codeThatThinks/io-master-dev-board/Readme.md

# io-master-dev-board

A dev board for continuing development of the I/O Master.
