codeThatThinks/io-master-dev-board/pdf/Schematic.pdf

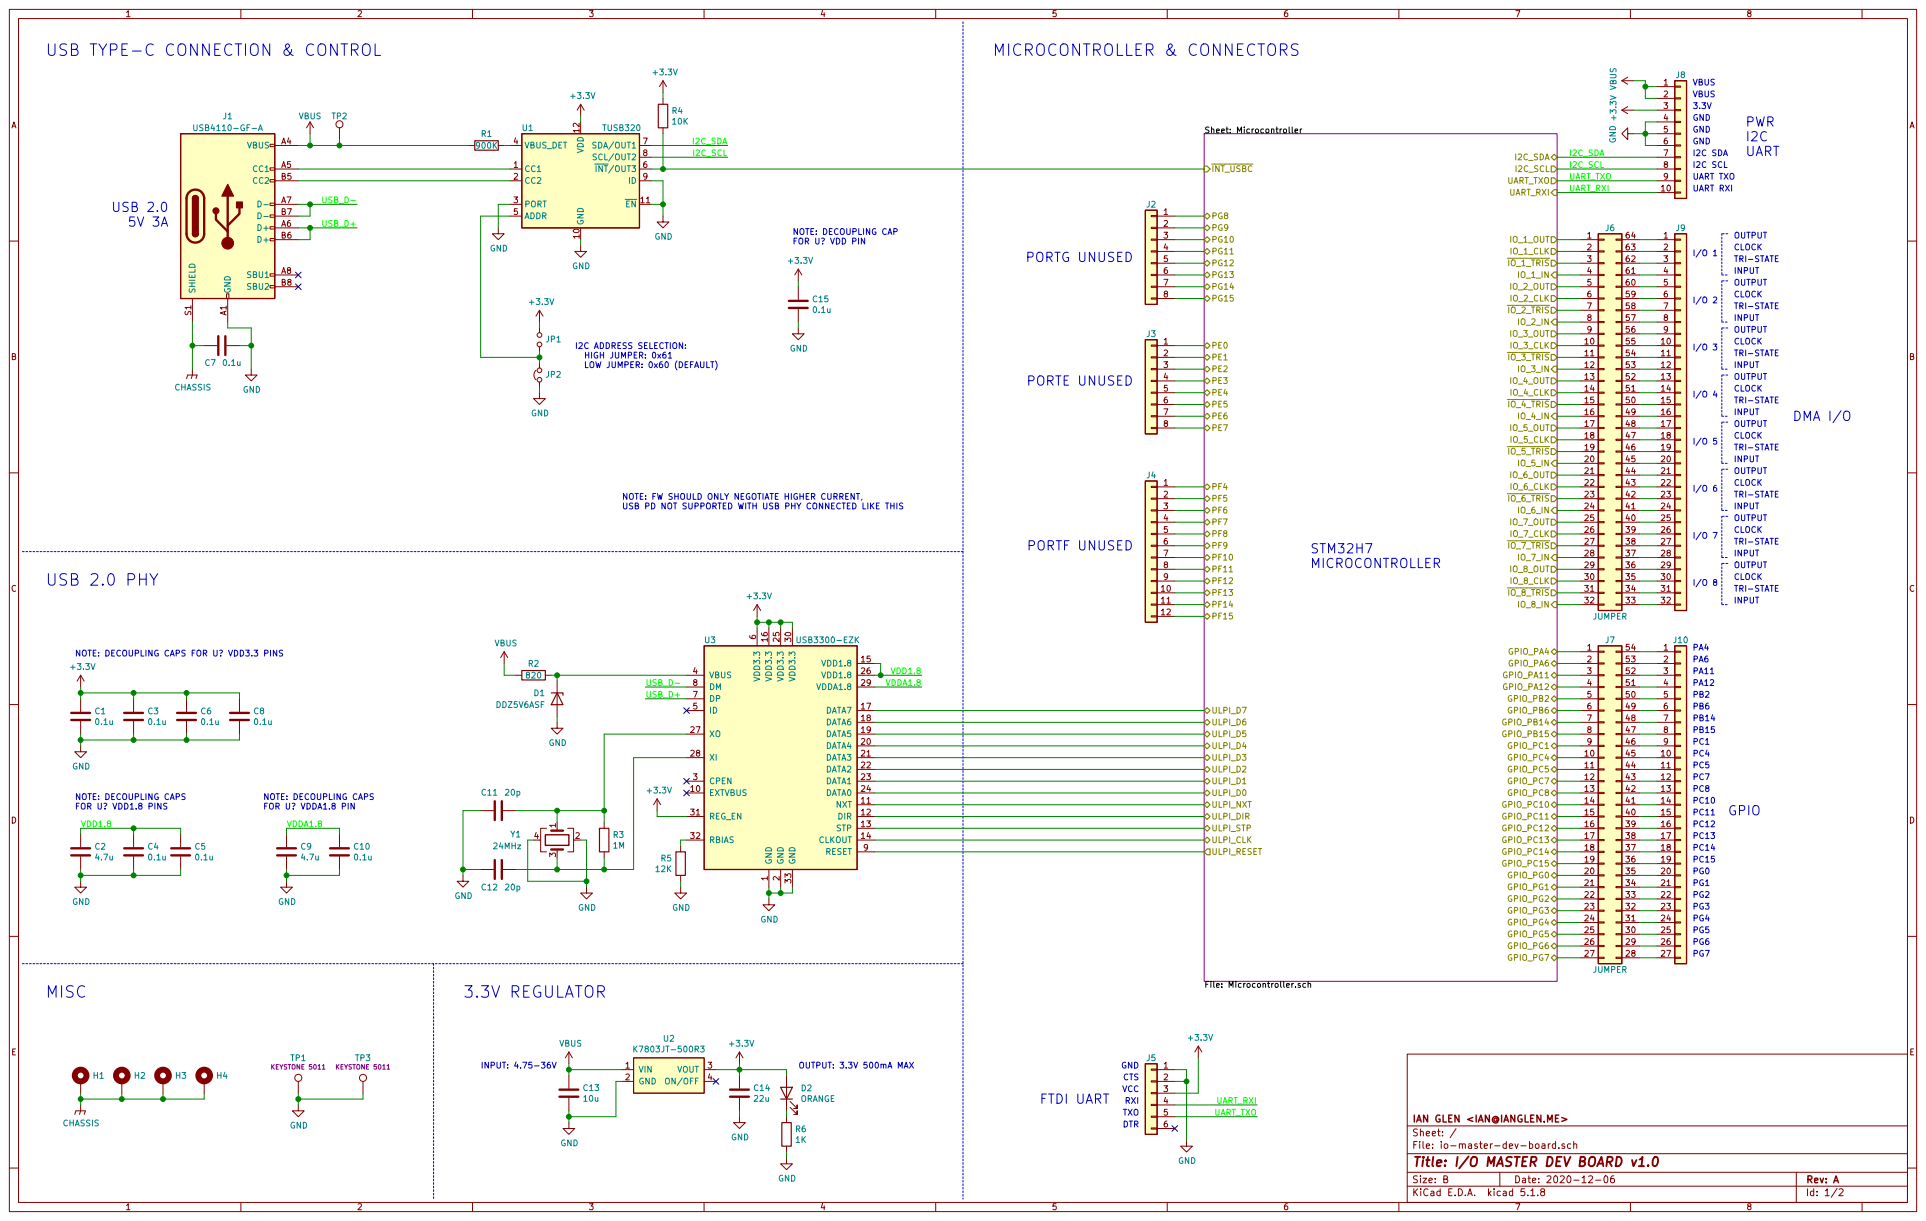
[picture p1: page 1]

FOR U? VDDA1.8 PIN USB TYPE-C CONNECTION & CONTROL

TRI-STATE CLOCK OUTPUT

4 | 2 | 63 2
5 | 3 | 62 3
6 | 4 | 61 4
7 | 5 | 60 5
8 | 6 | 59 6

7 | 58 7
8 | 57 8
9 | 56 9
10 | 55 10

2 | 11 | 54 11
3 | 12 | 53 12
4 | 13 | 52 13
5 | 14 | 51 14
6 | 15 | 50 15
7 | 16 | 49 16
8 | 17 | 48 17

18 | 47 18
19 | 46 19
20 | 45 20
21 | 44 21
22 | 43 22

2 | 23 | 42 23
3 | 24 | 41 24
4 | 25 | 40 25
5 | 26 | 39 26
6 | 27 | 38 27

9 | 30 | 35 30
10 | 31 | 34 31
11 | 32 | 33 32

6 DP 7 DM 8 RESET 9 U3 USB3300-EZK C1

1 EXTVBUS 10 NXT 11 DIR 12 STP 13 CLKOUT 14 VDD1.8 15 VDD3.3 16 DATA7 17 DATA6 18 DATA5 19 GND

2 DATA4 20 DATA3 21 DATA2 22 DATA1 23 DATA0 24 VDD3.3 25 VDD1.8 26 XO 27 XI 28 VDDA1.8 29 CPEN 3 VDD3.3 30 REG_EN 31 RBIAS 32 GND 33 VBUS 4

2 | 53 2
3 | 52 3
4 | 51 4
5 | 50 5
6 | 49 6
7 | 48 7
8 | 47 8
9 | 46 9
10 | 45 10
11 | 44 11
12 | 43 12
13 | 42 13
14 | 41 14
15 | 40 15
16 | 39 16
17 | 38 17
18 | 37 18
19 | 36 19
20 | 35 20

CTS NOTE: DECOUPLING CAPS

22 | 33 22
23 | 32 23
24 | 31 24
25 | 30 25
26 | 29 26
27 | 28 27

IAN GLEN <IAN@IANGLEN.ME>
File: io-master-dev-board.sch Sheet: /
Id: 1/2 Title: I/O MASTER DEV BOARD v1.0

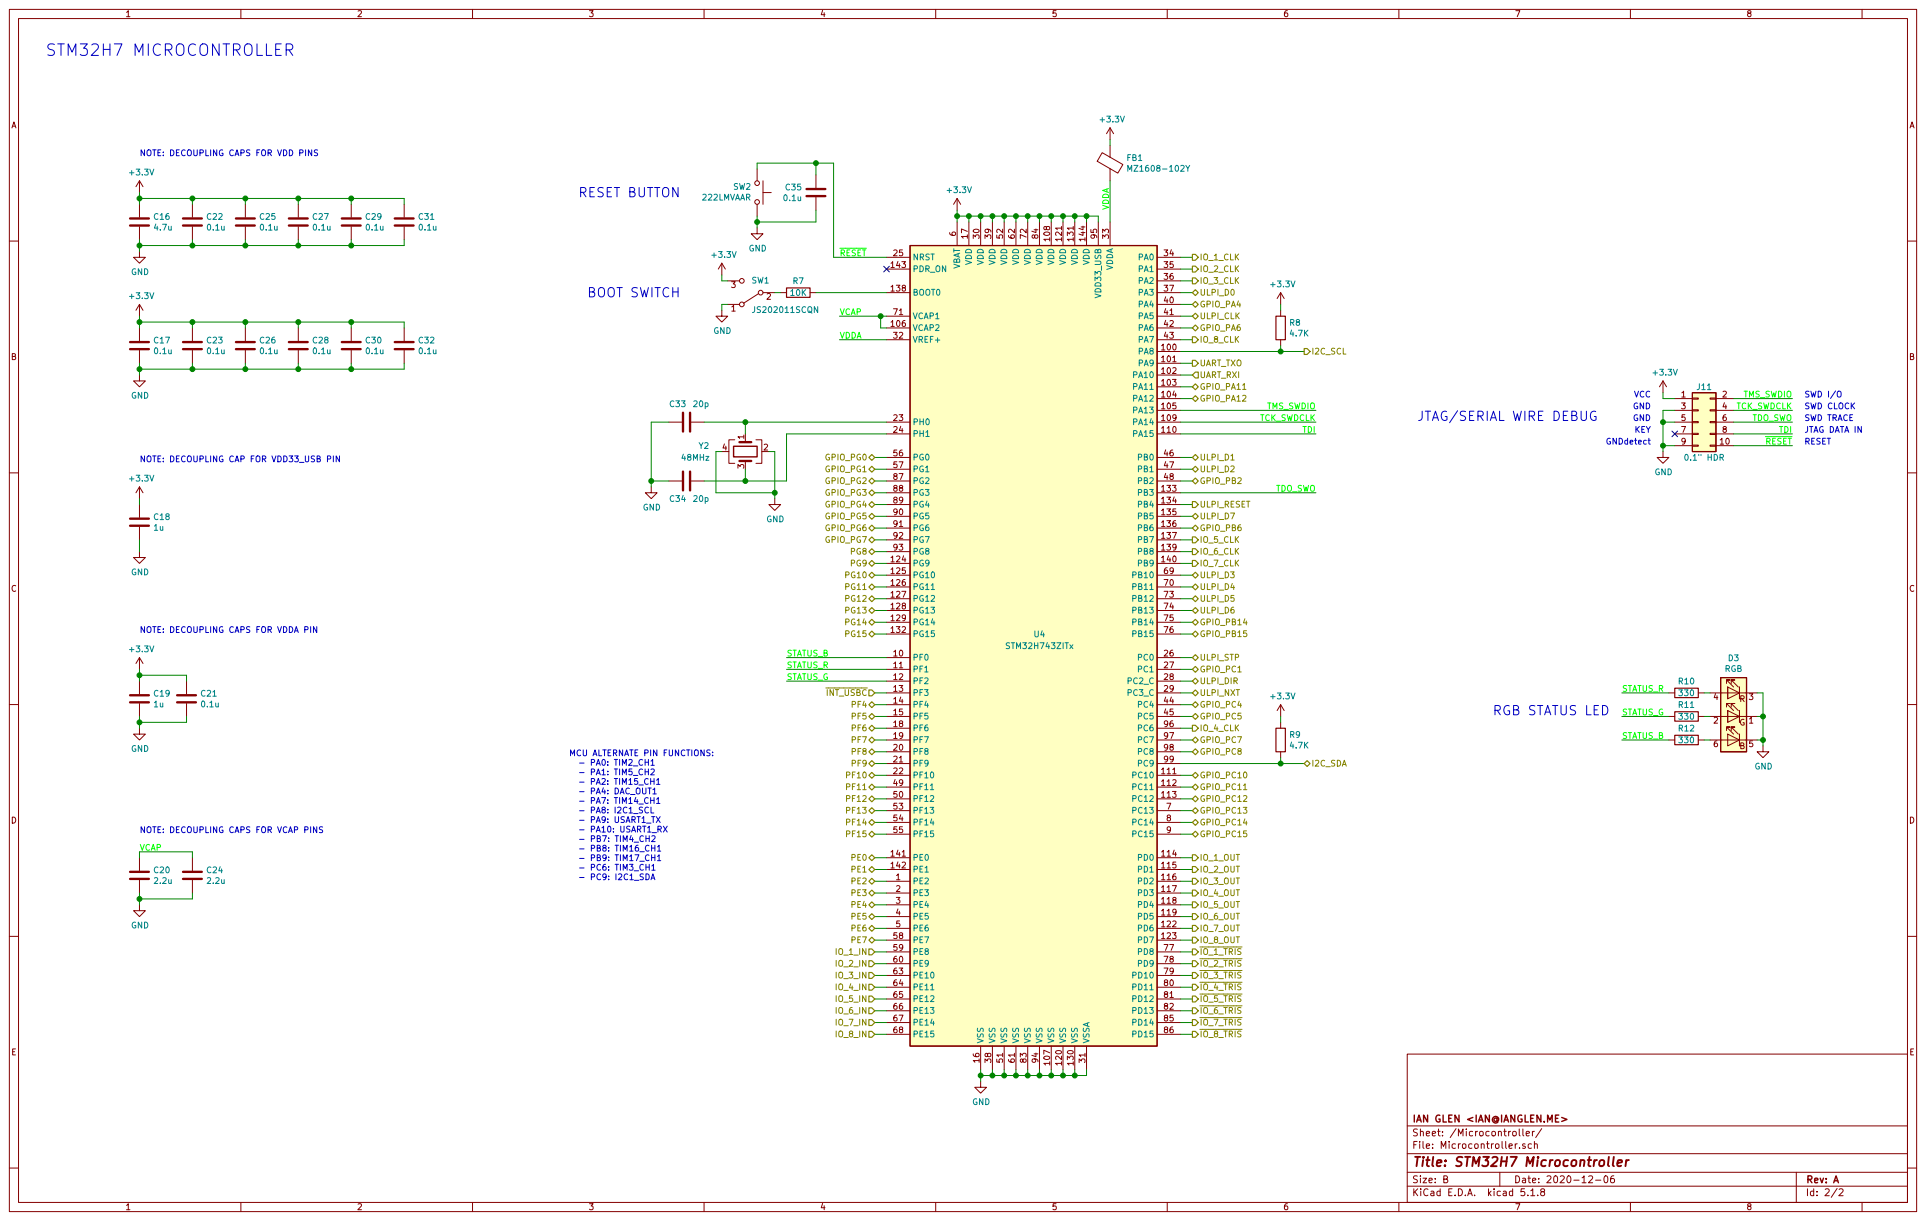
[picture p2: page 2]

JTAG/SERIAL WIRE DEBUG

NOTE: DECOUPLING CAP FOR VDD33_USB PIN

IAN GLEN <IAN@IANGLEN.ME> GND

Id: 2/2 Title: STM32H7 Microcontroller File: Microcontroller.sch Sheet: /Microcontroller/
