codeThatThinks/io-master-dev-board/kicad/io-master-dev-board.kicad_pcb

## KiCad design kicad/io-master-dev-board.kicad_pcb (2021-12-11)

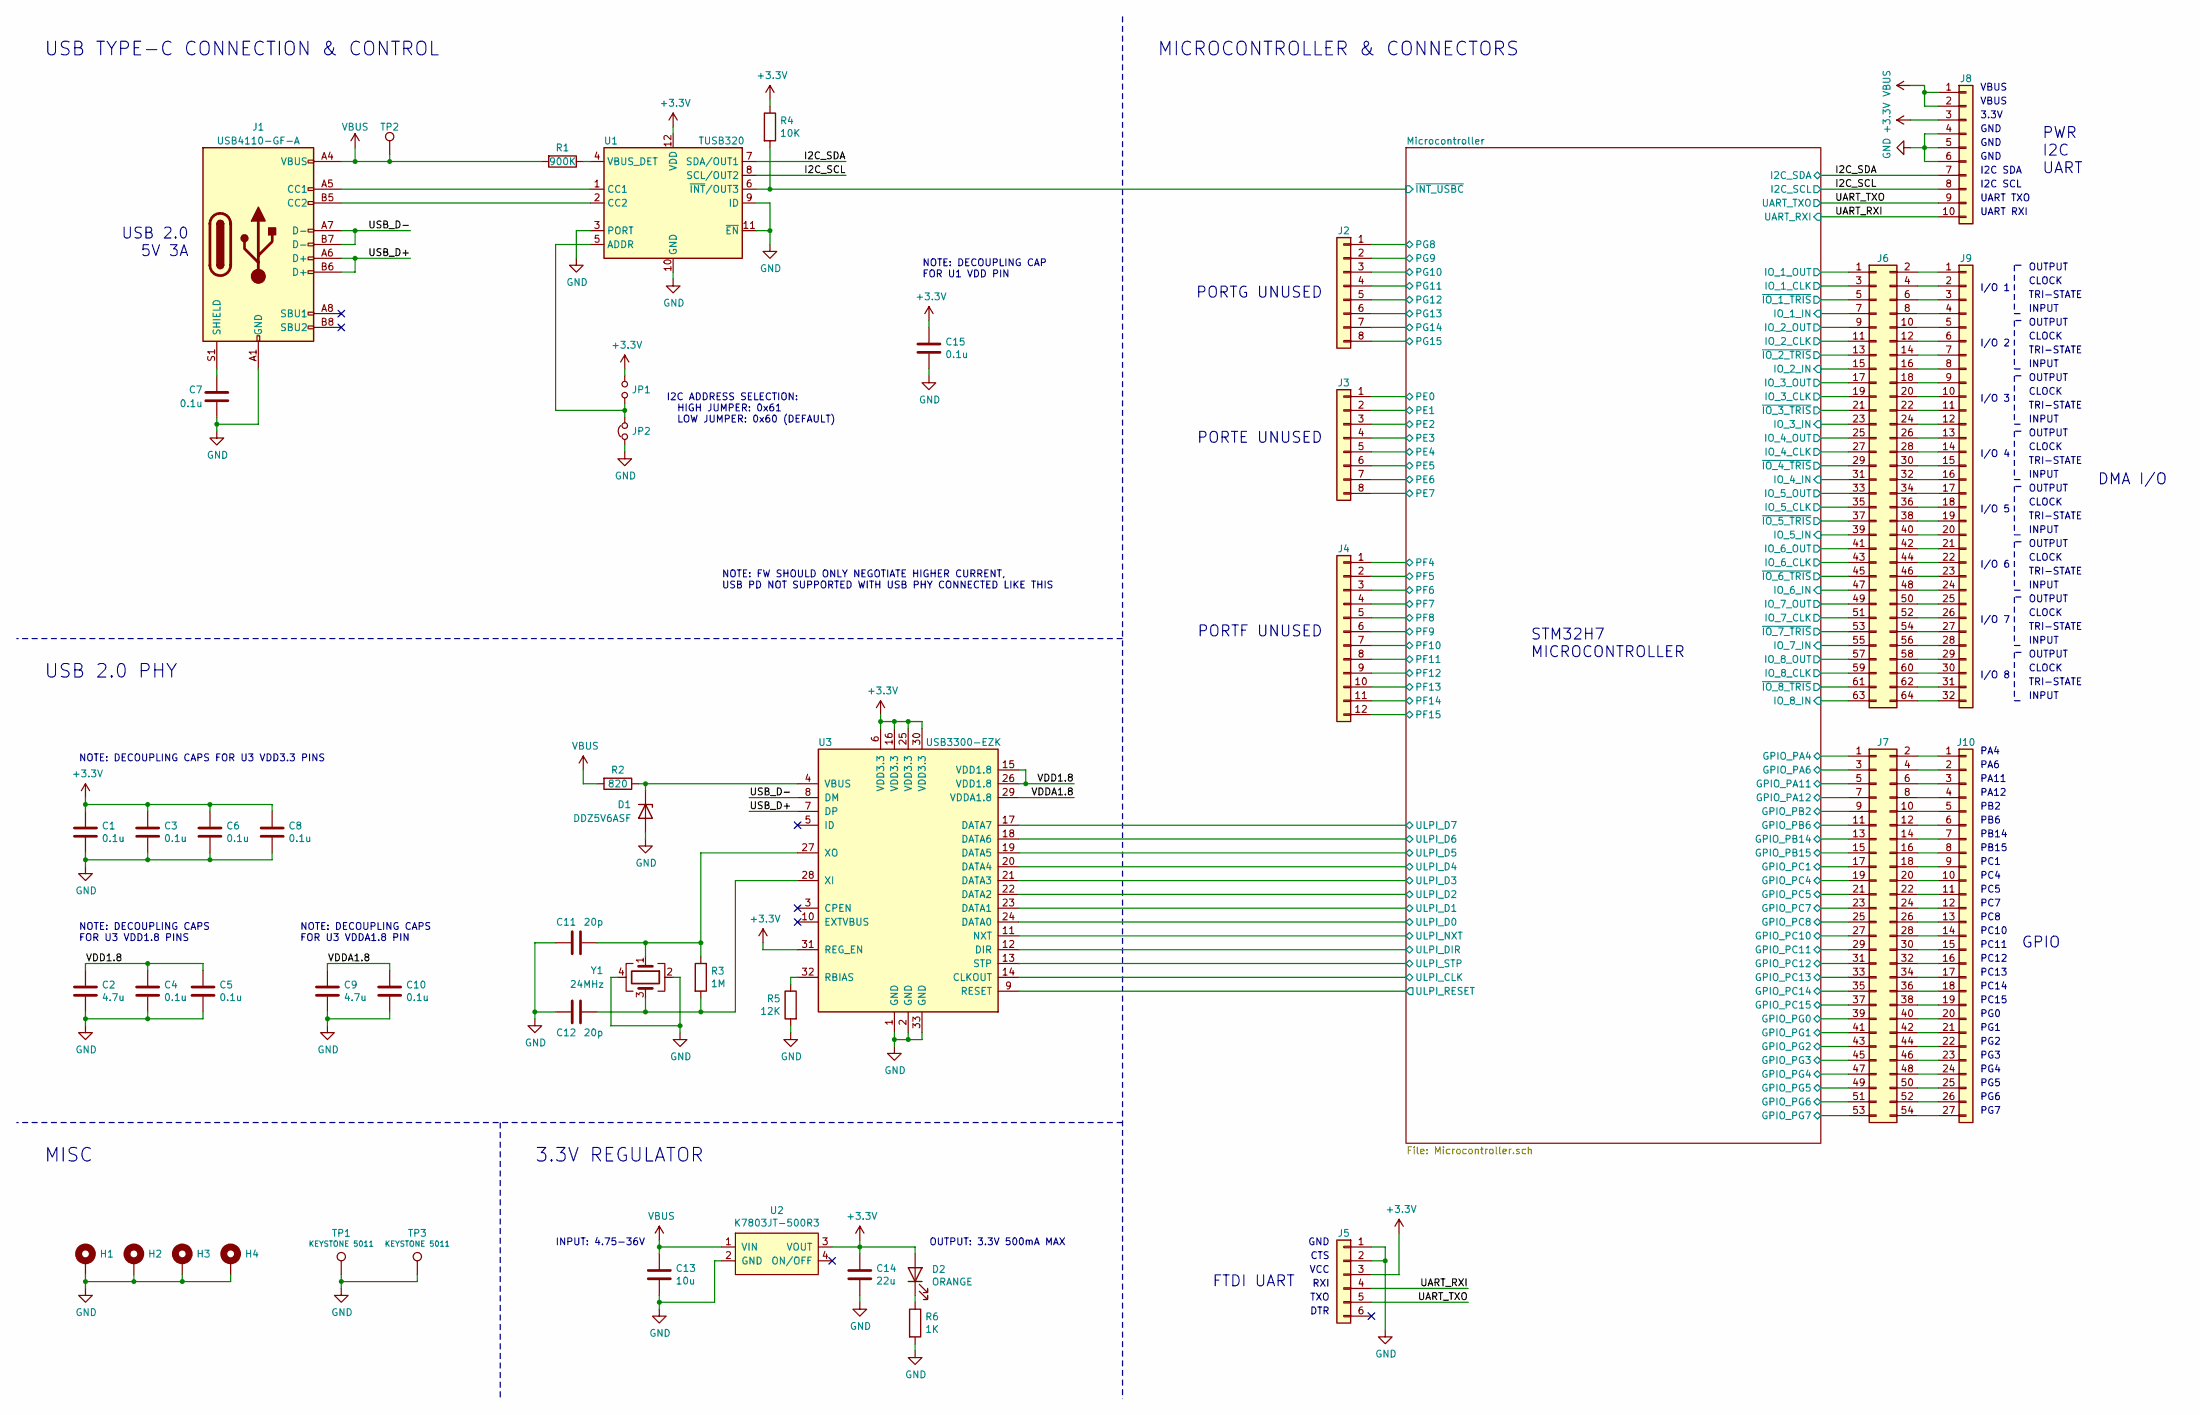
[picture p3: schematic io-master-dev-board.sch, I/O MASTER DEV BOARD v1.0]

Parts:
C1, C3, C4, C5, C6, C7, C8, C10, C15: 0.1u; C_0603_1608Metric
C2, C9: 4.7u; C_0805_2012Metric
C11, C12: 20p; C_0603_1608Metric
C13: 10u; C_0805_2012Metric
C14: 22u; C_1210_3225Metric
D1: DDZ5V6ASF; D_SOD-323F
D2: ORANGE; LED_0603_1608Metric
H1, H2, H3, H4: M3; MountingHole_3.2mm_M3_Pad
J1: USB4110-GF-A; USB_C_Receptable_GCT_USB4110
J2, J3: Conn_01x08; PinHeader_1x08_P2.54mm_Vertical
J4: Conn_01x12; PinHeader_1x12_P2.54mm_Vertical
J5: UART; PinHeader_1x06_P2.54mm_Horizontal
J6: Conn_02x32_Odd_Even; PinHeader_2x32_P1.27mm_Vertical
J7: Conn_02x27_Odd_Even; PinHeader_2x27_P1.27mm_Vertical
J8: Conn_01x10; PinHeader_1x10_P1.27mm_Vertical
J9: Conn_01x32; PinHeader_1x32_P1.27mm_Vertical
J10: Conn_01x27; PinHeader_1x27_P1.27mm_Vertical
JP1: Jumper_NO_Small; R_0603_1608Metric
JP2: Jumper_NC_Small; R_0603_1608Metric
R1: 900K; R_0603_1608Metric
R2: 820; R_0603_1608Metric
R3: 1M; R_0603_1608Metric
R4: 10K; R_0603_1608Metric
R5: 12K; R_0603_1608Metric
R6: 1K; R_0603_1608Metric
TP1, TP3: GND; TestPoint_Keystone_5010-5014_Multipurpose
TP2: VBUS; TestPoint_Pad_D1.0mm
U1: TUSB320; Texas_X2QFN-12_1.6x1.6mm_P0.4mm
U2: K7803JT-500R3; DCDC_Module_K78xxJT-500R3
U3: USB3300-EZK; QFN-32-1EP_5x5mm_P0.5mm_EP3.45x3.45mm
Y1: 24MHz; Crystal_SMD_Murata_XRCGB

Connections:
+3V3: C1.1, C3.1, C6.1, C8.1, C14.1, C15.1, D2.2 (A), J5.3, J8.3, JP1.2, R4.1, U1.12 (VDD), U2.3 (VOUT), U3.6 (VDD3.3), U3.16 (VDD3.3), U3.25 (VDD3.3), U3.30 (VDD3.3), U3.31 (REG_EN); also elsewhere on the board
/I2C_SCL: J8.8, U1.8 (SCL/OUT2); also elsewhere on the board
/I2C_SDA: J8.7, U1.7 (SDA/OUT1); also elsewhere on the board
/Microcontroller/GPIO_PA4: J7.1; also elsewhere on the board
/Microcontroller/GPIO_PA6: J7.3; also elsewhere on the board
/Microcontroller/GPIO_PA11: J7.5; also elsewhere on the board
/Microcontroller/GPIO_PA12: J7.7; also elsewhere on the board
/Microcontroller/GPIO_PB2: J7.9; also elsewhere on the board
/Microcontroller/GPIO_PB6: J7.11; also elsewhere on the board
/Microcontroller/GPIO_PB14: J7.13; also elsewhere on the board
/Microcontroller/GPIO_PB15: J7.15; also elsewhere on the board
/Microcontroller/GPIO_PC1: J7.17; also elsewhere on the board
/Microcontroller/GPIO_PC4: J7.19; also elsewhere on the board
/Microcontroller/GPIO_PC5: J7.21; also elsewhere on the board
/Microcontroller/GPIO_PC7: J7.23; also elsewhere on the board
/Microcontroller/GPIO_PC8: J7.25; also elsewhere on the board
/Microcontroller/GPIO_PC10: J7.27; also elsewhere on the board
/Microcontroller/GPIO_PC11: J7.29; also elsewhere on the board
/Microcontroller/GPIO_PC12: J7.31; also elsewhere on the board
/Microcontroller/GPIO_PC13: J7.33; also elsewhere on the board
/Microcontroller/GPIO_PC14: J7.35; also elsewhere on the board
/Microcontroller/GPIO_PC15: J7.37; also elsewhere on the board
/Microcontroller/GPIO_PG0: J7.39; also elsewhere on the board
/Microcontroller/GPIO_PG1: J7.41; also elsewhere on the board
/Microcontroller/GPIO_PG2: J7.43; also elsewhere on the board
/Microcontroller/GPIO_PG3: J7.45; also elsewhere on the board
/Microcontroller/GPIO_PG4: J7.47; also elsewhere on the board
/Microcontroller/GPIO_PG5: J7.49; also elsewhere on the board
/Microcontroller/GPIO_PG6: J7.51; also elsewhere on the board
/Microcontroller/GPIO_PG7: J7.53; also elsewhere on the board
/Microcontroller/IO_1_CLK: J6.3; also elsewhere on the board
/Microcontroller/IO_1_IN: J6.7; also elsewhere on the board
/Microcontroller/IO_1_OUT: J6.1; also elsewhere on the board
/Microcontroller/IO_2_CLK: J6.11; also elsewhere on the board
/Microcontroller/IO_2_IN: J6.15; also elsewhere on the board
/Microcontroller/IO_2_OUT: J6.9; also elsewhere on the board
/Microcontroller/IO_3_CLK: J6.19; also elsewhere on the board
/Microcontroller/IO_3_IN: J6.23; also elsewhere on the board
/Microcontroller/IO_3_OUT: J6.17; also elsewhere on the board
/Microcontroller/IO_4_CLK: J6.27; also elsewhere on the board
/Microcontroller/IO_4_IN: J6.31; also elsewhere on the board
/Microcontroller/IO_4_OUT: J6.25; also elsewhere on the board
/Microcontroller/IO_5_CLK: J6.35; also elsewhere on the board
/Microcontroller/IO_5_IN: J6.39; also elsewhere on the board
/Microcontroller/IO_5_OUT: J6.33; also elsewhere on the board
/Microcontroller/IO_6_CLK: J6.43; also elsewhere on the board
/Microcontroller/IO_6_IN: J6.47; also elsewhere on the board
/Microcontroller/IO_6_OUT: J6.41; also elsewhere on the board
/Microcontroller/IO_7_CLK: J6.51; also elsewhere on the board
/Microcontroller/IO_7_IN: J6.55; also elsewhere on the board
/Microcontroller/IO_7_OUT: J6.49; also elsewhere on the board
/Microcontroller/IO_8_CLK: J6.59; also elsewhere on the board
/Microcontroller/IO_8_IN: J6.63; also elsewhere on the board
/Microcontroller/IO_8_OUT: J6.57; also elsewhere on the board
/Microcontroller/PE0: J3.1; also elsewhere on the board
/Microcontroller/PE1: J3.2; also elsewhere on the board
/Microcontroller/PE2: J3.3; also elsewhere on the board
/Microcontroller/PE3: J3.4; also elsewhere on the board
/Microcontroller/PE4: J3.5; also elsewhere on the board
/Microcontroller/PE5: J3.6; also elsewhere on the board
/Microcontroller/PE6: J3.7; also elsewhere on the board
/Microcontroller/PE7: J3.8; also elsewhere on the board
/Microcontroller/PF4: J4.1; also elsewhere on the board
/Microcontroller/PF5: J4.2; also elsewhere on the board
/Microcontroller/PF6: J4.3; also elsewhere on the board
/Microcontroller/PF7: J4.4; also elsewhere on the board
/Microcontroller/PF8: J4.5; also elsewhere on the board
/Microcontroller/PF9: J4.6; also elsewhere on the board
/Microcontroller/PF10: J4.7; also elsewhere on the board
/Microcontroller/PF11: J4.8; also elsewhere on the board
/Microcontroller/PF12: J4.9; also elsewhere on the board
/Microcontroller/PF13: J4.10; also elsewhere on the board
/Microcontroller/PF14: J4.11; also elsewhere on the board
/Microcontroller/PF15: J4.12; also elsewhere on the board
/Microcontroller/PG8: J2.1; also elsewhere on the board
/Microcontroller/PG9: J2.2; also elsewhere on the board
/Microcontroller/PG10: J2.3; also elsewhere on the board
/Microcontroller/PG11: J2.4; also elsewhere on the board
/Microcontroller/PG12: J2.5; also elsewhere on the board
/Microcontroller/PG13: J2.6; also elsewhere on the board
/Microcontroller/PG14: J2.7; also elsewhere on the board
/Microcontroller/PG15: J2.8; also elsewhere on the board
/Microcontroller/ULPI_CLK: U3.14 (CLKOUT); also elsewhere on the board
/Microcontroller/ULPI_D0: U3.24 (DATA0); also elsewhere on the board
/Microcontroller/ULPI_D1: U3.23 (DATA1); also elsewhere on the board
/Microcontroller/ULPI_D2: U3.22 (DATA2); also elsewhere on the board
/Microcontroller/ULPI_D3: U3.21 (DATA3); also elsewhere on the board
/Microcontroller/ULPI_D4: U3.20 (DATA4); also elsewhere on the board
/Microcontroller/ULPI_D5: U3.19 (DATA5); also elsewhere on the board
/Microcontroller/ULPI_D6: U3.18 (DATA6); also elsewhere on the board
/Microcontroller/ULPI_D7: U3.17 (DATA7); also elsewhere on the board
/Microcontroller/ULPI_DIR: U3.12 (DIR); also elsewhere on the board
/Microcontroller/ULPI_NXT: U3.11 (NXT); also elsewhere on the board
/Microcontroller/ULPI_RESET: U3.9 (RESET); also elsewhere on the board
/Microcontroller/ULPI_STP: U3.13 (STP); also elsewhere on the board
/Microcontroller/~INT_USBC: R4.2, U1.6 (~INT~/OUT3); also elsewhere on the board
/Microcontroller/~IO_1_TRIS: J6.5; also elsewhere on the board
/Microcontroller/~IO_2_TRIS: J6.13; also elsewhere on the board
/Microcontroller/~IO_3_TRIS: J6.21; also elsewhere on the board
/Microcontroller/~IO_4_TRIS: J6.29; also elsewhere on the board
/Microcontroller/~IO_5_TRIS: J6.37; also elsewhere on the board
/Microcontroller/~IO_6_TRIS: J6.45; also elsewhere on the board
/Microcontroller/~IO_7_TRIS: J6.53; also elsewhere on the board
/Microcontroller/~IO_8_TRIS: J6.61; also elsewhere on the board
/UART_RXI: J5.4, J8.10; also elsewhere on the board
/UART_TXO: J5.5, J8.9; also elsewhere on the board
/USB_D+: J1.A6 (D+), J1.B6 (D+), U3.7 (DP)
/USB_D-: J1.A7 (D-), J1.B7 (D-), U3.8 (DM)
/VDD1.8: C2.1, C4.1, C5.1, U3.15 (VDD1.8), U3.26 (VDD1.8)
/VDDA1.8: C9.1, C10.1, U3.29 (VDDA1.8)
GND: C1.2, C2.2, C3.2, C4.2, C5.2, C6.2, C7.1, C8.2, C9.2, C10.2, C11.2, C12.2, C13.2, C14.2, C15.2, D1.2 (A), H1.1, H2.1, H3.1, H4.1, J1.A1 (GND), J1.A12 (GND), J1.B1 (GND), J1.B12 (GND), J5.1, J5.2, J8.4, J8.5, J8.6, JP2.1, R5.2, R6.2, TP1.1, TP3.1, U1.3 (PORT), U1.9 (ID), U1.10 (GND), U1.11 (~EN), U2.2 (GND), U3.1 (GND), U3.2 (GND), U3.33 (GND), Y1.2, Y1.4; also elsewhere on the board
unnamed: C7.2, J1.S1 (SHIELD)
unnamed: C11.1, R3.1, U3.27 (XO), Y1.1
unnamed: C12.1, R3.2, U3.28 (XI), Y1.3
unnamed: D1.1 (K), R2.1, U3.4 (VBUS)
unnamed: D2.1 (K), R6.1
unnamed: J1.A5 (CC1), U1.1 (CC1)
unnamed: J1.B5 (CC2), U1.2 (CC2)
unnamed: J6.2, J9.1
unnamed: J6.4, J9.2
unnamed: J6.6, J9.3
unnamed: J6.8, J9.4
unnamed: J6.10, J9.5
unnamed: J6.12, J9.6
unnamed: J6.14, J9.7
unnamed: J6.16, J9.8
unnamed: J6.18, J9.9
unnamed: J6.20, J9.10
unnamed: J6.22, J9.11
unnamed: J6.24, J9.12
unnamed: J6.26, J9.13
unnamed: J6.28, J9.14
unnamed: J6.30, J9.15
unnamed: J6.32, J9.16
unnamed: J6.34, J9.17
unnamed: J6.36, J9.18
unnamed: J6.38, J9.19
unnamed: J6.40, J9.20
unnamed: J6.42, J9.21
unnamed: J6.44, J9.22
unnamed: J6.46, J9.23
unnamed: J6.48, J9.24
unnamed: J6.50, J9.25
unnamed: J6.52, J9.26
unnamed: J6.54, J9.27
unnamed: J6.56, J9.28
unnamed: J6.58, J9.29
unnamed: J6.60, J9.30
unnamed: J6.62, J9.31
unnamed: J6.64, J9.32
unnamed: J7.2, J10.1
unnamed: J7.4, J10.2
unnamed: J7.6, J10.3
unnamed: J7.8, J10.4
unnamed: J7.10, J10.5
unnamed: J7.12, J10.6
unnamed: J7.14, J10.7
unnamed: J7.16, J10.8
unnamed: J7.18, J10.9
unnamed: J7.20, J10.10
unnamed: J7.22, J10.11
unnamed: J7.24, J10.12
unnamed: J7.26, J10.13
unnamed: J7.28, J10.14
unnamed: J7.30, J10.15
unnamed: J7.32, J10.16
unnamed: J7.34, J10.17
unnamed: J7.36, J10.18
unnamed: J7.38, J10.19
unnamed: J7.40, J10.20
unnamed: J7.42, J10.21
unnamed: J7.44, J10.22
unnamed: J7.46, J10.23
unnamed: J7.48, J10.24
unnamed: J7.50, J10.25
unnamed: J7.52, J10.26
unnamed: J7.54, J10.27
unnamed: JP1.1, JP2.2, U1.5 (ADDR)
unnamed: R1.1, U1.4 (VBUS_DET)
unnamed: R5.1, U3.32 (RBIAS)
VBUS: C13.1, J1.A4 (VBUS), J1.A9 (VBUS), J1.B4 (VBUS), J1.B9 (VBUS), J8.1, J8.2, R1.2, R2.2, TP2.1, U2.1 (VIN)

Notes on the sheet:
NOTE: DECOUPLING CAPS FOR U3 VDD1.8 PINS
NOTE: DECOUPLING CAPS FOR U3 VDD3.3 PINS
NOTE: DECOUPLING CAPS FOR U3 VDDA1.8 PIN
USB TYPE-C CONNECTION & CONTROL
USB 2.0 5V 3A
3.3V REGULATOR
I2C ADDRESS SELECTION: HIGH JUMPER: 0x61 LOW JUMPER: 0x60 (DEFAULT)
NOTE: DECOUPLING CAP FOR U1 VDD PIN
INPUT: 4.75-36V
OUTPUT: 3.3V 500mA MAX
STM32H7 MICROCONTROLLER
USB 2.0 PHY
MISC
MICROCONTROLLER & CONNECTORS
PWR I2C UART
DMA I/O
VBUS
3.3V
GND
I2C SDA
I2C SCL
UART TXO
UART RXI
I/O 1
OUTPUT
CLOCK
TRI-STATE
INPUT
I/O 2
I/O 3
I/O 4
I/O 5
I/O 6
I/O 7
I/O 8
GPIO
PA4
PA6
PA11
PA12
PB2
PB6
PB14
PB15
PC1
PC4
PC5
PC7
PC8
PC10
PC11
PC12
PC13
PC14
PC15
PG0
PG1
PG2
PG3
PG4
PG5
PG6
PG7
PORTG UNUSED
PORTE UNUSED
PORTF UNUSED
VCC
TXO
RXI
FTDI UART
CTS
DTR
NOTE: FW SHOULD ONLY NEGOTIATE HIGHER CURRENT, USB PD NOT SUPPORTED WITH USB PHY CONNECTED LIKE THIS

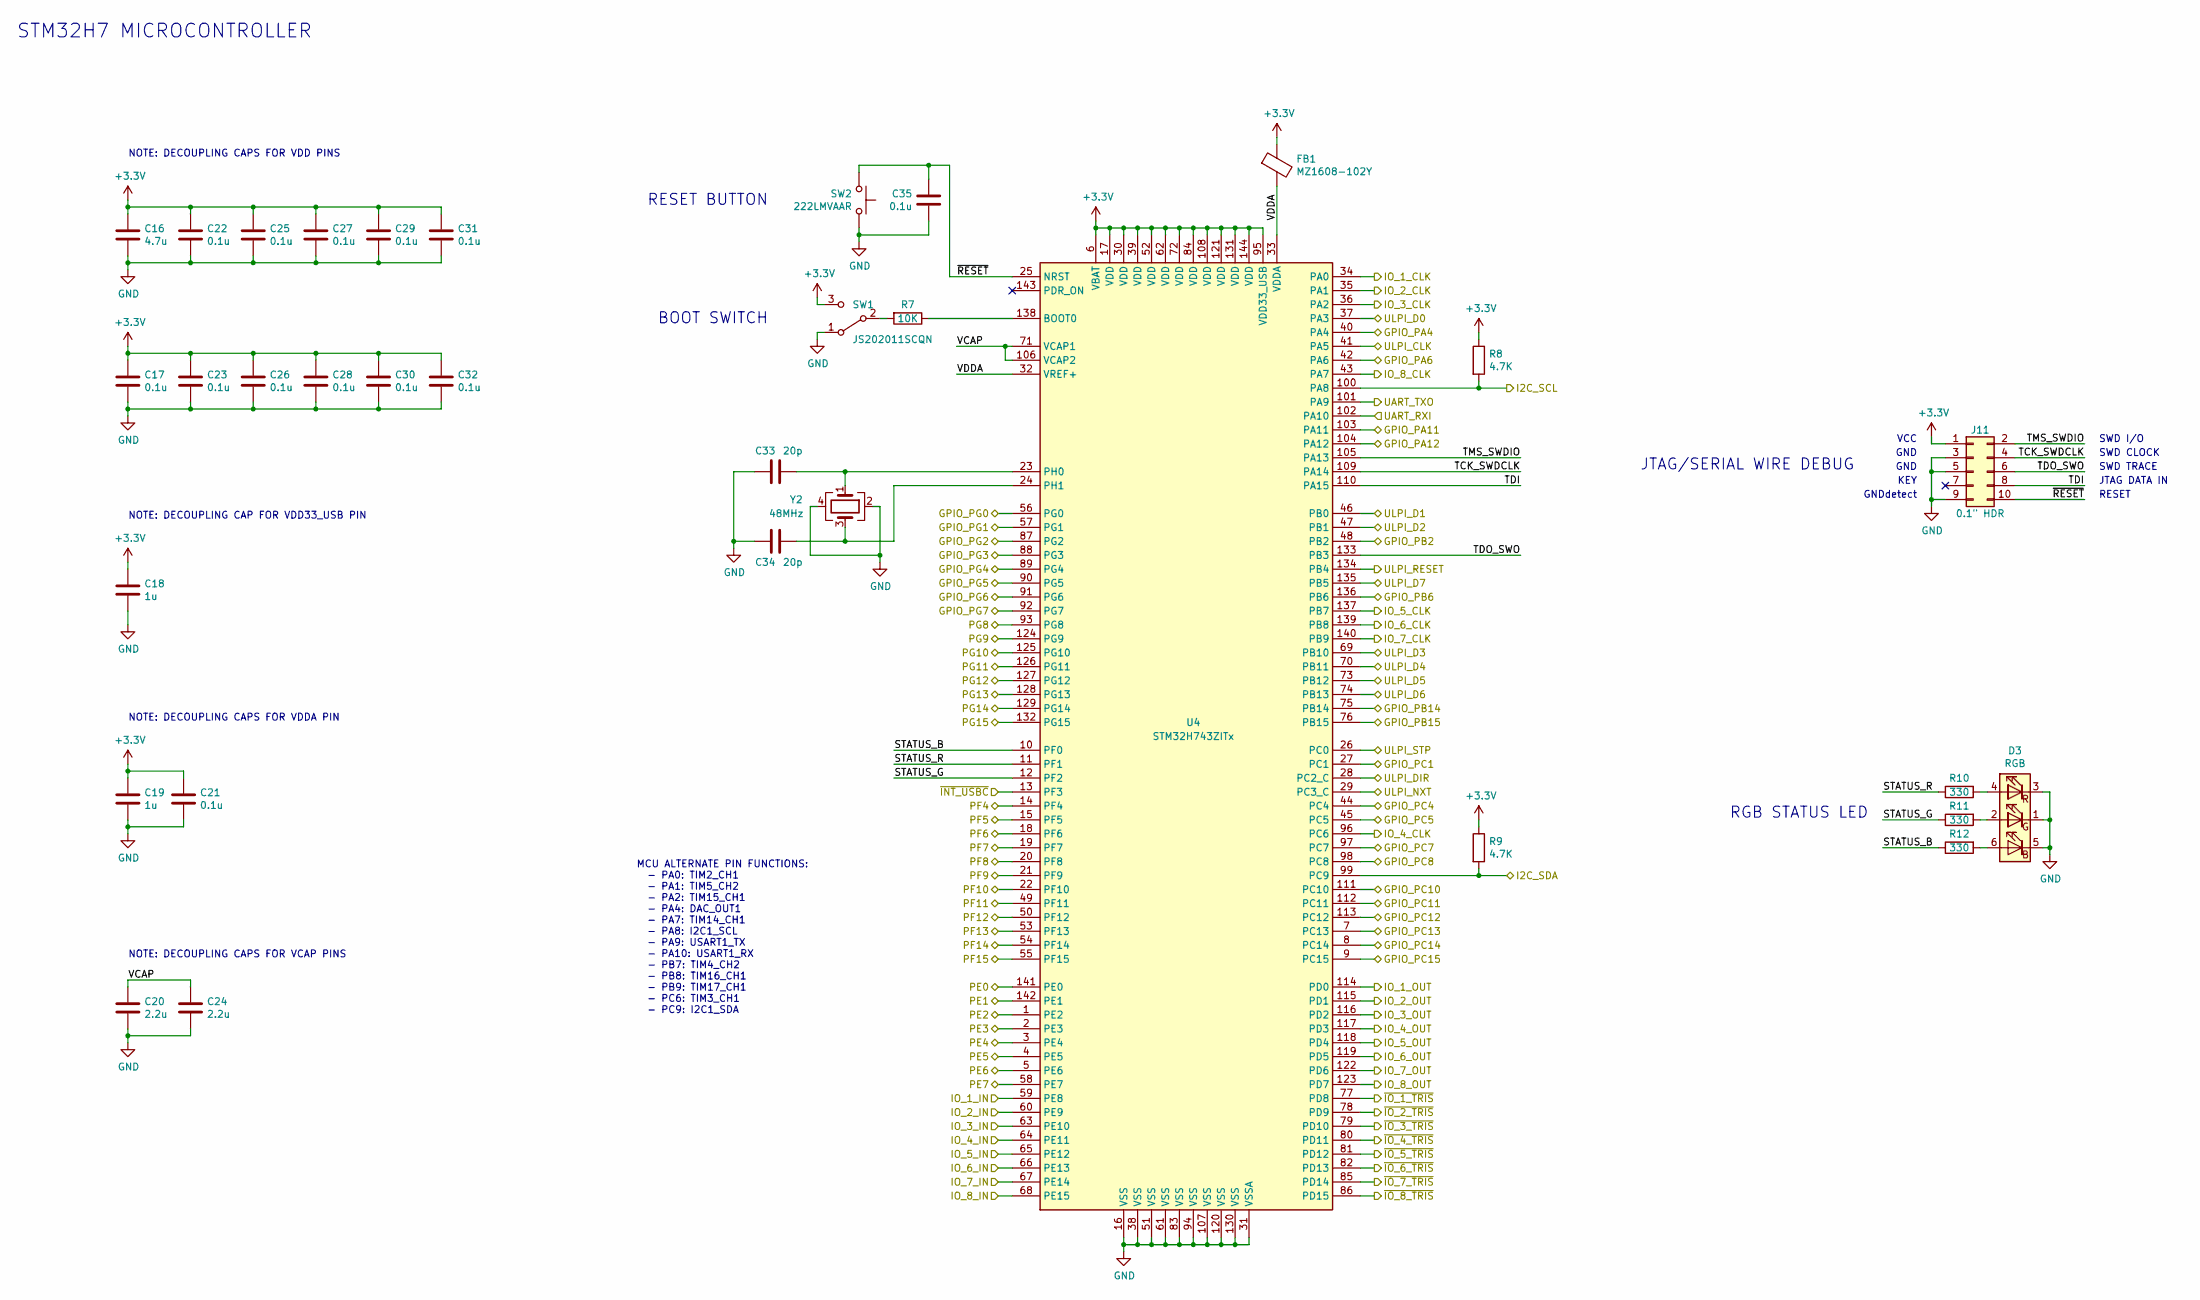
[picture p4: schematic Microcontroller.sch, STM32H7 Microcontroller]

Parts:
C16: 4.7u; C_0805_2012Metric
C17, C21, C22, C23, C25, C26, C27, C28, C29, C30, C31, C32, C35: 0.1u; C_0603_1608Metric
C18, C19: 1u; C_0603_1608Metric
C20, C24: 2.2u; C_0805_2012Metric
C33, C34: 20p; C_0603_1608Metric
D3: RGB; LED_Everlight_19-337C
FB1: MZ1608-102Y; R_0603_1608Metric
J11: 0.1\" HDR; PinSocket_2x05_P2.54mm_Vertical
R7: 10K; R_0603_1608Metric
R8, R9: 4.7K; R_0603_1608Metric
R10, R11, R12: 330; R_0603_1608Metric
SW1: JS202011SCQN; SW_DPDT_CK_JS202011SCQN
SW2: 222LMVAAR; SW_Push_CTS_222LMVA
U4: STM32H743ZITx; LQFP-144_20x20mm_P0.5mm
Y2: 48MHz; Crystal_SMD_Murata_XRCGB

Connections:
+3V3: C16.1, C17.1, C18.1, C19.1, C21.1, C22.1, C23.1, C25.1, C26.1, C27.1, C28.1, C29.1, C30.1, C31.1, C32.1, FB1.1, J11.1, R8.1, R9.1, SW1.3 (C), U4.6 (VBAT), U4.17 (VDD), U4.30 (VDD), U4.39 (VDD), U4.52 (VDD), U4.62 (VDD), U4.72 (VDD), U4.84 (VDD), U4.95 (VDD33_USB), U4.108 (VDD), U4.121 (VDD), U4.131 (VDD), U4.144 (VDD); also elsewhere on the board
/I2C_SCL: R8.2, U4.100 (PA8); also elsewhere on the board
/I2C_SDA: R9.2, U4.99 (PC9); also elsewhere on the board
/Microcontroller/GPIO_PA4: U4.40 (PA4); also elsewhere on the board
/Microcontroller/GPIO_PA6: U4.42 (PA6); also elsewhere on the board
/Microcontroller/GPIO_PA11: U4.103 (PA11); also elsewhere on the board
/Microcontroller/GPIO_PA12: U4.104 (PA12); also elsewhere on the board
/Microcontroller/GPIO_PB2: U4.48 (PB2); also elsewhere on the board
/Microcontroller/GPIO_PB6: U4.136 (PB6); also elsewhere on the board
/Microcontroller/GPIO_PB14: U4.75 (PB14); also elsewhere on the board
/Microcontroller/GPIO_PB15: U4.76 (PB15); also elsewhere on the board
/Microcontroller/GPIO_PC1: U4.27 (PC1); also elsewhere on the board
/Microcontroller/GPIO_PC4: U4.44 (PC4); also elsewhere on the board
/Microcontroller/GPIO_PC5: U4.45 (PC5); also elsewhere on the board
/Microcontroller/GPIO_PC7: U4.97 (PC7); also elsewhere on the board
/Microcontroller/GPIO_PC8: U4.98 (PC8); also elsewhere on the board
/Microcontroller/GPIO_PC10: U4.111 (PC10); also elsewhere on the board
/Microcontroller/GPIO_PC11: U4.112 (PC11); also elsewhere on the board
/Microcontroller/GPIO_PC12: U4.113 (PC12); also elsewhere on the board
/Microcontroller/GPIO_PC13: U4.7 (PC13); also elsewhere on the board
/Microcontroller/GPIO_PC14: U4.8 (PC14); also elsewhere on the board
/Microcontroller/GPIO_PC15: U4.9 (PC15); also elsewhere on the board
/Microcontroller/GPIO_PG0: U4.56 (PG0); also elsewhere on the board
/Microcontroller/GPIO_PG1: U4.57 (PG1); also elsewhere on the board
/Microcontroller/GPIO_PG2: U4.87 (PG2); also elsewhere on the board
/Microcontroller/GPIO_PG3: U4.88 (PG3); also elsewhere on the board
/Microcontroller/GPIO_PG4: U4.89 (PG4); also elsewhere on the board
/Microcontroller/GPIO_PG5: U4.90 (PG5); also elsewhere on the board
/Microcontroller/GPIO_PG6: U4.91 (PG6); also elsewhere on the board
/Microcontroller/GPIO_PG7: U4.92 (PG7); also elsewhere on the board
/Microcontroller/IO_1_CLK: U4.34 (PA0); also elsewhere on the board
/Microcontroller/IO_1_IN: U4.59 (PE8); also elsewhere on the board
/Microcontroller/IO_1_OUT: U4.114 (PD0); also elsewhere on the board
/Microcontroller/IO_2_CLK: U4.35 (PA1); also elsewhere on the board
/Microcontroller/IO_2_IN: U4.60 (PE9); also elsewhere on the board
/Microcontroller/IO_2_OUT: U4.115 (PD1); also elsewhere on the board
/Microcontroller/IO_3_CLK: U4.36 (PA2); also elsewhere on the board
/Microcontroller/IO_3_IN: U4.63 (PE10); also elsewhere on the board
/Microcontroller/IO_3_OUT: U4.116 (PD2); also elsewhere on the board
/Microcontroller/IO_4_CLK: U4.96 (PC6); also elsewhere on the board
/Microcontroller/IO_4_IN: U4.64 (PE11); also elsewhere on the board
/Microcontroller/IO_4_OUT: U4.117 (PD3); also elsewhere on the board
/Microcontroller/IO_5_CLK: U4.137 (PB7); also elsewhere on the board
/Microcontroller/IO_5_IN: U4.65 (PE12); also elsewhere on the board
/Microcontroller/IO_5_OUT: U4.118 (PD4); also elsewhere on the board
/Microcontroller/IO_6_CLK: U4.139 (PB8); also elsewhere on the board
/Microcontroller/IO_6_IN: U4.66 (PE13); also elsewhere on the board
/Microcontroller/IO_6_OUT: U4.119 (PD5); also elsewhere on the board
/Microcontroller/IO_7_CLK: U4.140 (PB9); also elsewhere on the board
/Microcontroller/IO_7_IN: U4.67 (PE14); also elsewhere on the board
/Microcontroller/IO_7_OUT: U4.122 (PD6); also elsewhere on the board
/Microcontroller/IO_8_CLK: U4.43 (PA7); also elsewhere on the board
/Microcontroller/IO_8_IN: U4.68 (PE15); also elsewhere on the board
/Microcontroller/IO_8_OUT: U4.123 (PD7); also elsewhere on the board
/Microcontroller/PE0: U4.141 (PE0); also elsewhere on the board
/Microcontroller/PE1: U4.142 (PE1); also elsewhere on the board
/Microcontroller/PE2: U4.1 (PE2); also elsewhere on the board
/Microcontroller/PE3: U4.2 (PE3); also elsewhere on the board
/Microcontroller/PE4: U4.3 (PE4); also elsewhere on the board
/Microcontroller/PE5: U4.4 (PE5); also elsewhere on the board
/Microcontroller/PE6: U4.5 (PE6); also elsewhere on the board
/Microcontroller/PE7: U4.58 (PE7); also elsewhere on the board
/Microcontroller/PF4: U4.14 (PF4); also elsewhere on the board
/Microcontroller/PF5: U4.15 (PF5); also elsewhere on the board
/Microcontroller/PF6: U4.18 (PF6); also elsewhere on the board
/Microcontroller/PF7: U4.19 (PF7); also elsewhere on the board
/Microcontroller/PF8: U4.20 (PF8); also elsewhere on the board
/Microcontroller/PF9: U4.21 (PF9); also elsewhere on the board
/Microcontroller/PF10: U4.22 (PF10); also elsewhere on the board
/Microcontroller/PF11: U4.49 (PF11); also elsewhere on the board
/Microcontroller/PF12: U4.50 (PF12); also elsewhere on the board
/Microcontroller/PF13: U4.53 (PF13); also elsewhere on the board
/Microcontroller/PF14: U4.54 (PF14); also elsewhere on the board
/Microcontroller/PF15: U4.55 (PF15); also elsewhere on the board
/Microcontroller/PG8: U4.93 (PG8); also elsewhere on the board
/Microcontroller/PG9: U4.124 (PG9); also elsewhere on the board
/Microcontroller/PG10: U4.125 (PG10); also elsewhere on the board
/Microcontroller/PG11: U4.126 (PG11); also elsewhere on the board
/Microcontroller/PG12: U4.127 (PG12); also elsewhere on the board
/Microcontroller/PG13: U4.128 (PG13); also elsewhere on the board
/Microcontroller/PG14: U4.129 (PG14); also elsewhere on the board
/Microcontroller/PG15: U4.132 (PG15); also elsewhere on the board
/Microcontroller/STATUS_B: R12.1, U4.10 (PF0)
/Microcontroller/STATUS_G: R11.1, U4.12 (PF2)
/Microcontroller/STATUS_R: R10.1, U4.11 (PF1)
/Microcontroller/TCK_SWDCLK: J11.4, U4.109 (PA14)
/Microcontroller/TDI: J11.8, U4.110 (PA15)
/Microcontroller/TDO_SWO: J11.6, U4.133 (PB3)
/Microcontroller/TMS_SWDIO: J11.2, U4.105 (PA13)
/Microcontroller/ULPI_CLK: U4.41 (PA5); also elsewhere on the board
/Microcontroller/ULPI_D0: U4.37 (PA3); also elsewhere on the board
/Microcontroller/ULPI_D1: U4.46 (PB0); also elsewhere on the board
/Microcontroller/ULPI_D2: U4.47 (PB1); also elsewhere on the board
/Microcontroller/ULPI_D3: U4.69 (PB10); also elsewhere on the board
/Microcontroller/ULPI_D4: U4.70 (PB11); also elsewhere on the board
/Microcontroller/ULPI_D5: U4.73 (PB12); also elsewhere on the board
/Microcontroller/ULPI_D6: U4.74 (PB13); also elsewhere on the board
/Microcontroller/ULPI_D7: U4.135 (PB5); also elsewhere on the board
/Microcontroller/ULPI_DIR: U4.28 (PC2_C); also elsewhere on the board
/Microcontroller/ULPI_NXT: U4.29 (PC3_C); also elsewhere on the board
/Microcontroller/ULPI_RESET: U4.134 (PB4); also elsewhere on the board
/Microcontroller/ULPI_STP: U4.26 (PC0); also elsewhere on the board
/Microcontroller/VCAP: C20.1, C24.1, U4.71 (VCAP1), U4.106 (VCAP2)
/Microcontroller/VDDA: FB1.2, U4.32 (VREF+), U4.33 (VDDA)
/Microcontroller/~INT_USBC: U4.13 (PF3); also elsewhere on the board
/Microcontroller/~IO_1_TRIS: U4.77 (PD8); also elsewhere on the board
/Microcontroller/~IO_2_TRIS: U4.78 (PD9); also elsewhere on the board
/Microcontroller/~IO_3_TRIS: U4.79 (PD10); also elsewhere on the board
/Microcontroller/~IO_4_TRIS: U4.80 (PD11); also elsewhere on the board
/Microcontroller/~IO_5_TRIS: U4.81 (PD12); also elsewhere on the board
/Microcontroller/~IO_6_TRIS: U4.82 (PD13); also elsewhere on the board
/Microcontroller/~IO_7_TRIS: U4.85 (PD14); also elsewhere on the board
/Microcontroller/~IO_8_TRIS: U4.86 (PD15); also elsewhere on the board
/Microcontroller/~RESET: C35.1, J11.10, SW2.2, U4.25 (NRST)
/UART_RXI: U4.102 (PA10); also elsewhere on the board
/UART_TXO: U4.101 (PA9); also elsewhere on the board
GND: C16.2, C17.2, C18.2, C19.2, C20.2, C21.2, C22.2, C23.2, C24.2, C25.2, C26.2, C27.2, C28.2, C29.2, C30.2, C31.2, C32.2, C33.2, C34.2, C35.2, D3.1 (GK), D3.3 (RK), D3.5 (BK), J11.3, J11.5, J11.9, SW1.1 (A), SW2.1, U4.16 (VSS), U4.31 (VSSA), U4.38 (VSS), U4.51 (VSS), U4.61 (VSS), U4.83 (VSS), U4.94 (VSS), U4.107 (VSS), U4.120 (VSS), U4.130 (VSS), Y2.2, Y2.4; also elsewhere on the board
unnamed: C33.1, U4.23 (PH0), Y2.1
unnamed: C34.1, U4.24 (PH1), Y2.3
unnamed: D3.2 (GA), R11.2
unnamed: D3.4 (RA), R10.2
unnamed: D3.6 (BA), R12.2
unnamed: R7.1, U4.138 (BOOT0)
unnamed: R7.2, SW1.2 (B)

Notes on the sheet:
STM32H7 MICROCONTROLLER
JTAG/SERIAL WIRE DEBUG
SWD I/O
SWD CLOCK
SWD TRACE
JTAG DATA IN
RESET
VCC
GND
KEY
GNDdetect
NOTE: DECOUPLING CAPS FOR VDDA PIN
NOTE: DECOUPLING CAPS FOR VDD PINS
NOTE: DECOUPLING CAP FOR VDD33_USB PIN
BOOT SWITCH
RGB STATUS LED
RESET BUTTON
NOTE: DECOUPLING CAPS FOR VCAP PINS
MCU ALTERNATE PIN FUNCTIONS: - PA0: TIM2_CH1 - PA1: TIM5_CH2 - PA2: TIM15_CH1 - PA4: DAC_OUT1 - PA7: TIM14_CH1 - PA8: I2C1_SCL - PA9: USART1_TX - PA10: USART1_RX - PB7: TIM4_CH2 - PB8: TIM16_CH1 - PB9: TIM17_CH1 - PC6: TIM3_CH1 - PC9: I2C1_SDA

Board: 2 copper layers, 79 parts (0 on the bottom side), 198 nets, no tracks yet.
