codeThatThinks/io-master-dev-board/(commit log)

2020-12-06 Modify I/O Master v1.0 schematic
    [15V Regulator.sch, Microcontroller.sch, io-master-dev-board.kicad_pcb, io-master-dev-board.sch]
2021-12-11 WIP board layout
    [io-master-dev-board.kicad_pcb, io-master-dev-board.sch]
